Designcorenet/FRUGT/README.md

# FRUGT
An open source, affordable and accessible plant cultivation system.               
Note: This repository is still in its beginning.

WhatsApp Image 2023-02-15 at 18 12 42
