Designcorenet/FRUGT/DOCS/Flyer.pdf

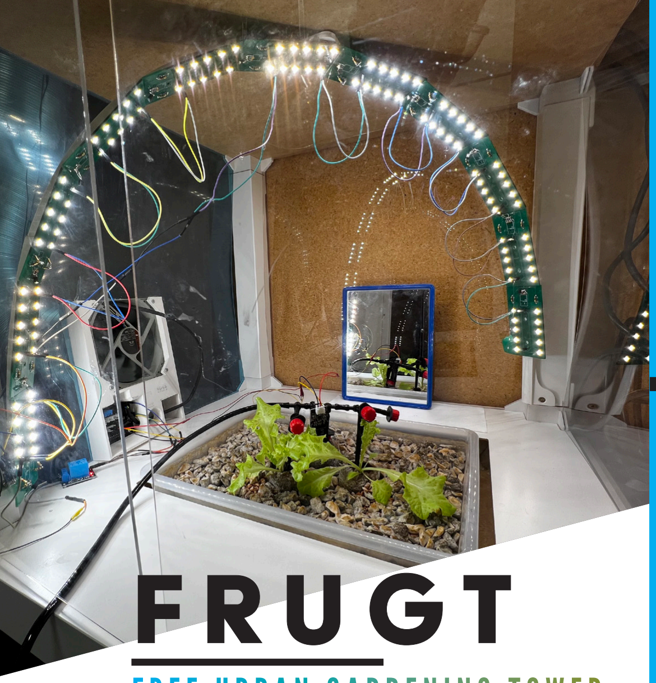
[picture p1: figure]
FRUGT

# KONTAKT

# EIN VORTEIL?

Der Pflanzenanbau innerhalb eines komplett von natürlichem Licht abgeschotteten FRUGT-System wurde untersucht. Die Pflanzen, welche innerhalb des Systems keimten, wurden sieben Tage nach der Keimung pickiert und separiert. Ein Teil blieb im System und ein anderer wurde auf einer Fensterbank im Februar in einer Wohnung platziert.

Die Pflanzen innerhalb des FRUGT-Systems hatten ein fast doppelt so hohes Feuchtgewicht und wiesen ein höheres Absorptionsspektrum auf. Dies ist ein Indikator für höheres Pflanzenwachstum.

Der eigene Anbau von Nutzpflanzen ist heutzutage substanziell, da dieser die Lieferketten verkürzt und somit mehr Autarkie ermöglicht und die Pflanzen nicht mit Pestiziden behandelt sind. Jedoch haben viele Menschen z.B. in Großstädten oft keine Möglichkeiten zum eigenen Pflanzenanbau und dieser gestaltet sich außerdem meist sehr zeitintensiv. Deswegen hat FRUGT das Ziel, der Entwicklung eines autarken für die breite Gesellschaft leicht zugänglichen Pflanzenanbau-Systems.

# Tim Weber

### Tel: +49 173 1045848 E-Mail: designcorenet@gmail.com https://github.com/Designcorenet

# FREE URBAN GARDENING TOWER

# E I N G R O S S E S D A N K E S C H Ö N F Ü R DIE UNTERSTÜTZUNG DURCH:

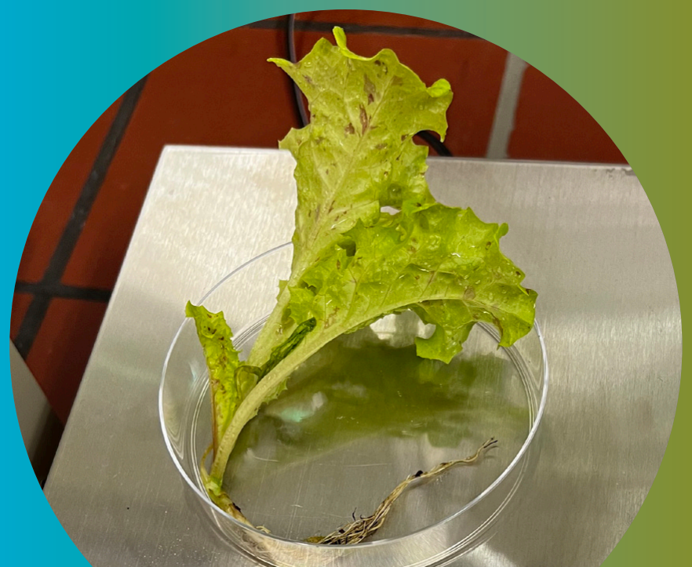
[picture p2: figure]

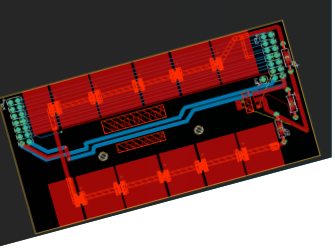
[picture p3: figure]

# DAS SYSTEM

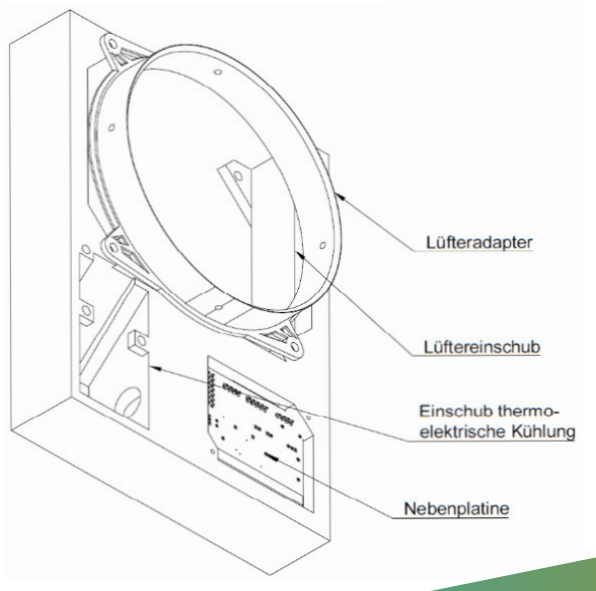
[picture p4: figure]
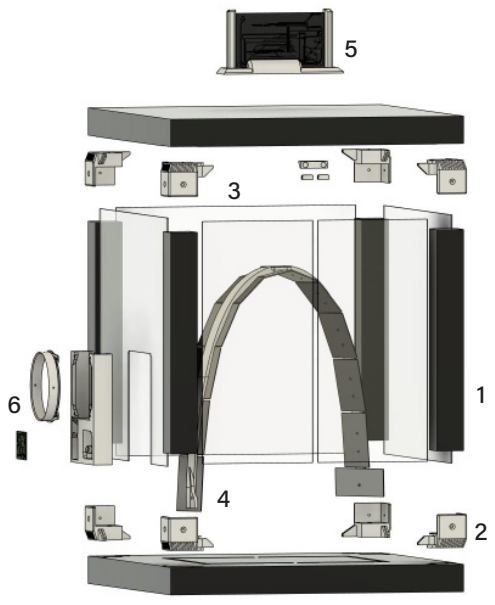
[picture p5: figure]

# DIE BELEUCHTUNG

Um einen möglichst effizienten Pflanzenanbau zu erreichen, der ebenfalls eine gewisse Preiswertigkeit und Autarkie aufweist, wurde ein System aus folgenden Komponenten entwickelt:

1. Ikea Lack Beistelltisch
2. 3D-gedruckte Zwischenteile
3. Plexiglas
4. LED-Beleuchtungsbogen
5. Hauptplatinen-Modul
6. Nebenplatinen-Modul
Um die Pflanzen auch im Winter oder in wenig beleuchteten Räumen effizient anbauen zu können, wurde ein LED-Beleuchtungsbogen entwickelt. Dieser besteht aus zwölf Platinen, welche einzeln ansteuerbar sind. Der Beleuchtungsbogen verfügt insgesamt über 120 LM301H LEDs mit einem für den Pflanzenanbau optimierten Spektrum.

# DIE ELEKTRONIK

Hauptplatinen-Modul:
- Arduino Mega 2560 als Herzstück
- ESP32-CAM für Datenlogging und Verbindung zum Internet
- Temperatur-/
Luftfeuchtigkeitssensor
- Hauptplatine ist mit bis zu drei Nebenplatinen verbindbar
--> bis zu dreistöckiges System möglich
Nebenplatinen-Modul:
- Bodenfeuchtigkeitssensor
- Beleuchtungsstärkensensor
- Temperatur-/
Luftfeuchtigkeitssensor
- Durchflusssensor
- PWM-Lüfter
- ws2182b Status-LED
