Designcorenet/FRUGT/STLs/enclosure_system/hinge_(4x).stl

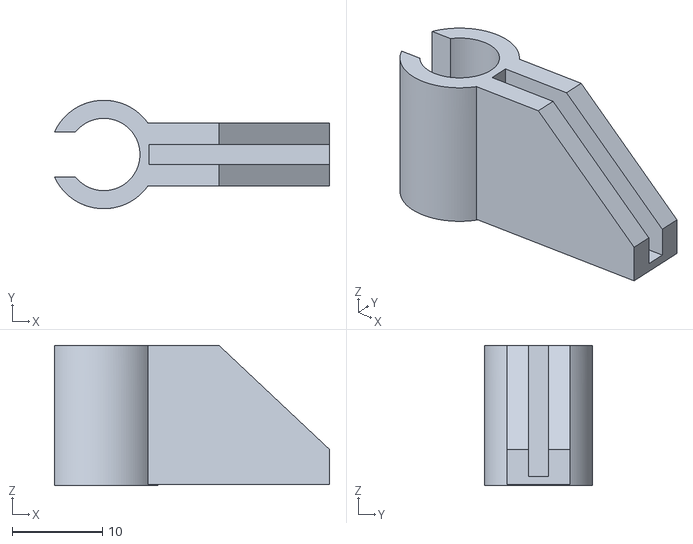
[picture p41: CAD file, 2022-09-10]
STLs/enclosure_system/hinge_(4x).stl
30.4 x 12.0 x 15.5
