Designcorenet/FRUGT/STLs/lightning/lightning_arc_a_(1x).stl

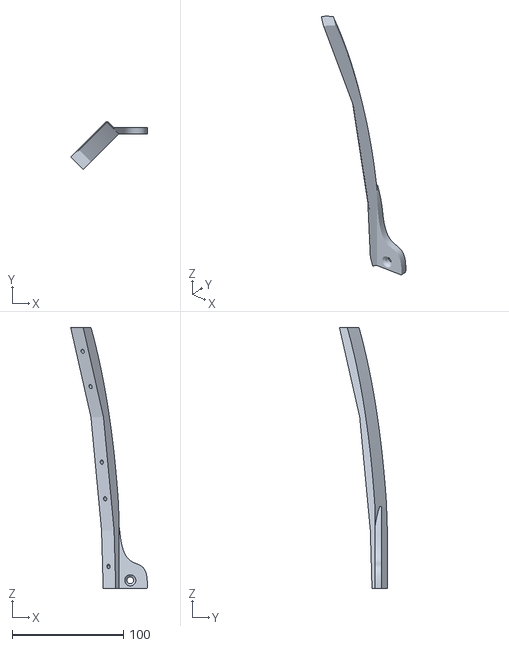
[picture p42: CAD file, 2022-09-10]
STLs/lightning/lightning_arc_a_(1x).stl
69.1 x 43.3 x 235.0
