Designcorenet/FRUGT/STLs/SEC_PCB/125_ventpipe_adapter_(1x).stl

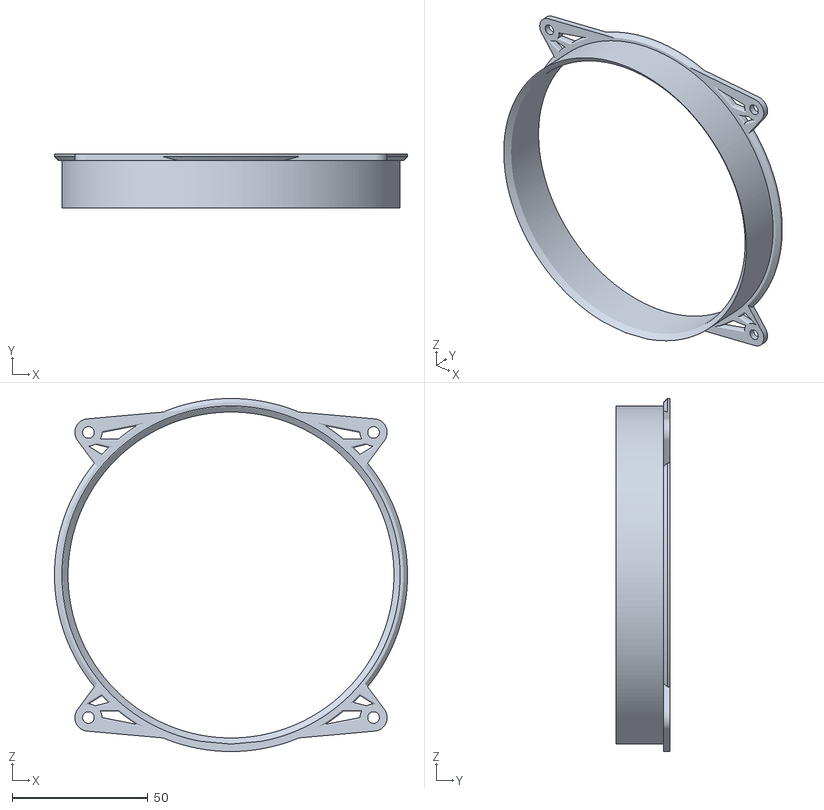
[picture p43: CAD file, 2022-09-10]
STLs/SEC_PCB/125_ventpipe_adapter_(1x).stl
130.0 x 20.0 x 130.0
