Designcorenet/FRUGT/STLs/enclosure_system/hinge_corner_piece_ b_(2x).stl

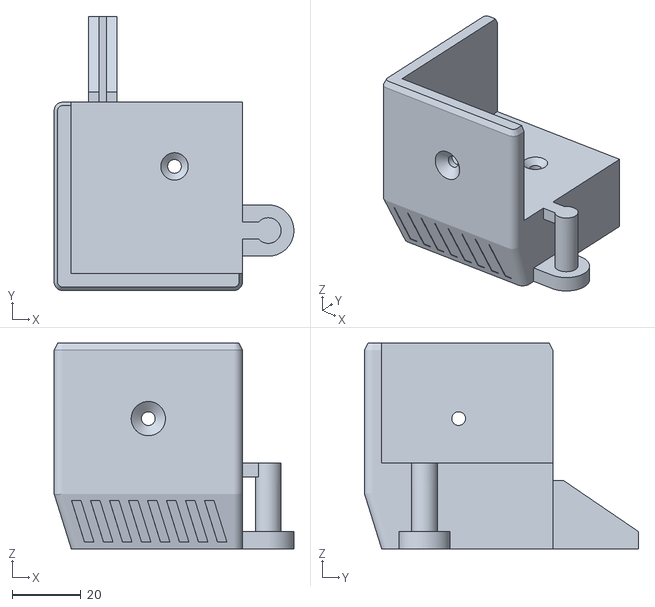
[picture p44: CAD file, 2022-09-10]
STLs/enclosure_system/hinge_corner_piece_ b_(2x).stl
70.0 x 80.0 x 60.0
