Designcorenet/FRUGT/STLs/lightning/lightning_arc_c_(1x).stl

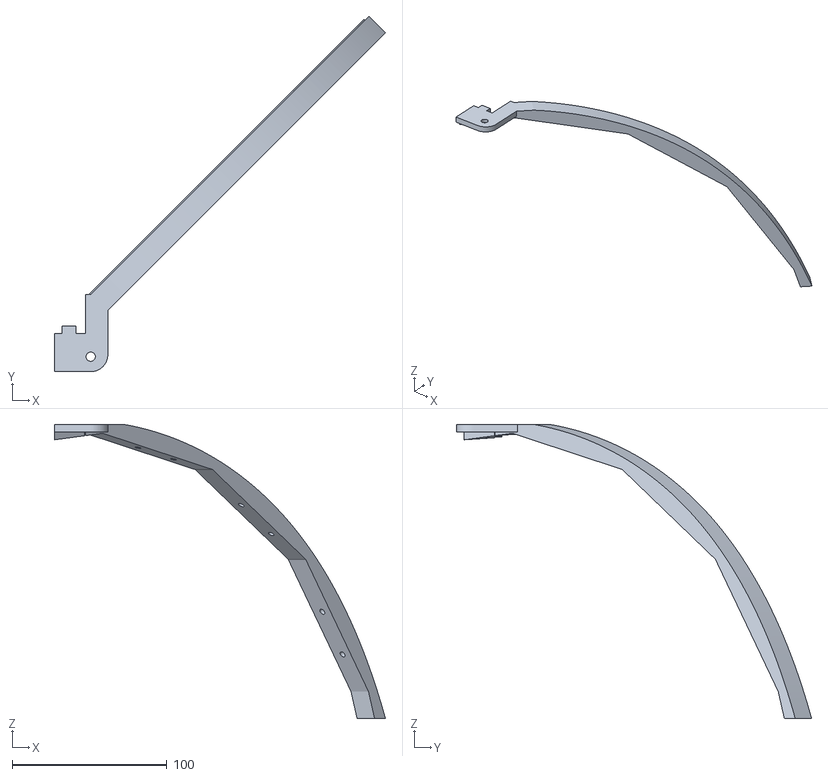
[picture p45: CAD file, 2022-09-10]
STLs/lightning/lightning_arc_c_(1x).stl
213.9 x 229.6 x 190.0
