Designcorenet/FRUGT/STLs/SEC_PCB/case_(1x).stl

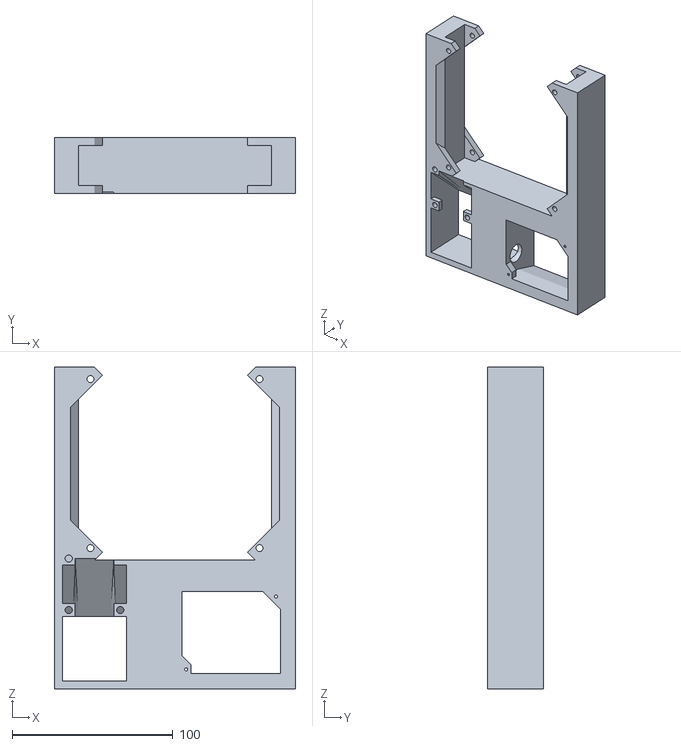
[picture p46: CAD file, 2022-09-10]
STLs/SEC_PCB/case_(1x).stl
150.0 x 35.0 x 200.0
