Designcorenet/FRUGT/STLs/enclosure_system/corner_piece_(4x).stl

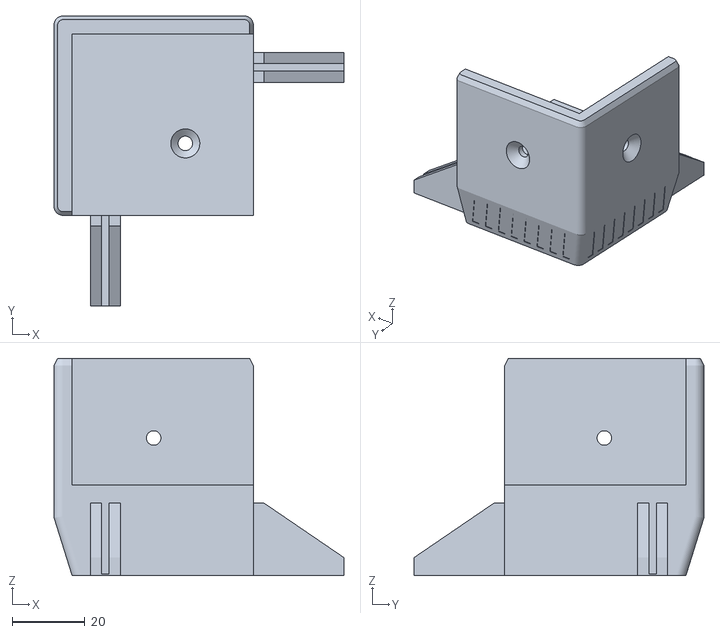
[picture p47: CAD file, 2022-09-10]
STLs/enclosure_system/corner_piece_(4x).stl
80.0 x 80.0 x 60.0
