Designcorenet/FRUGT/STLs/lightning/lightning_arc_d_(1x).stl

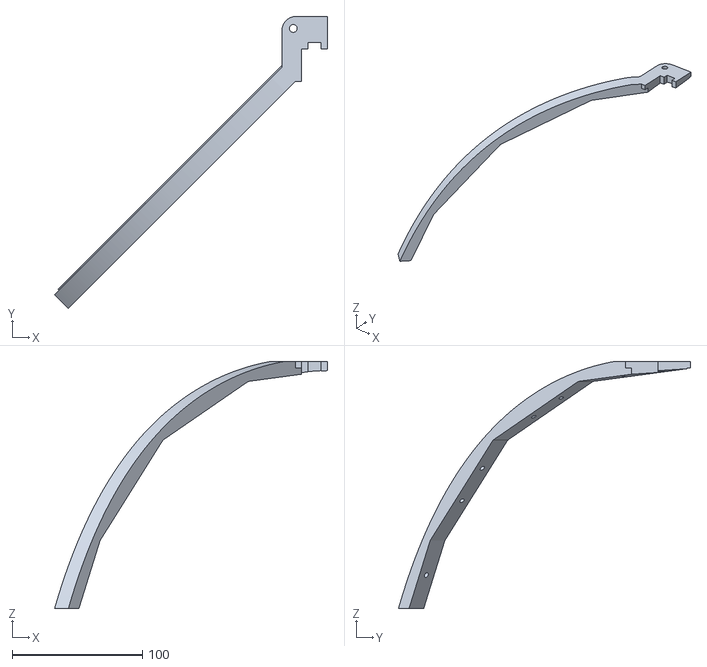
[picture p48: CAD file, 2022-09-10]
STLs/lightning/lightning_arc_d_(1x).stl
209.6 x 224.4 x 190.0
