Designcorenet/FRUGT/STLs/lightning/lightning_arc_b_(1x).stl

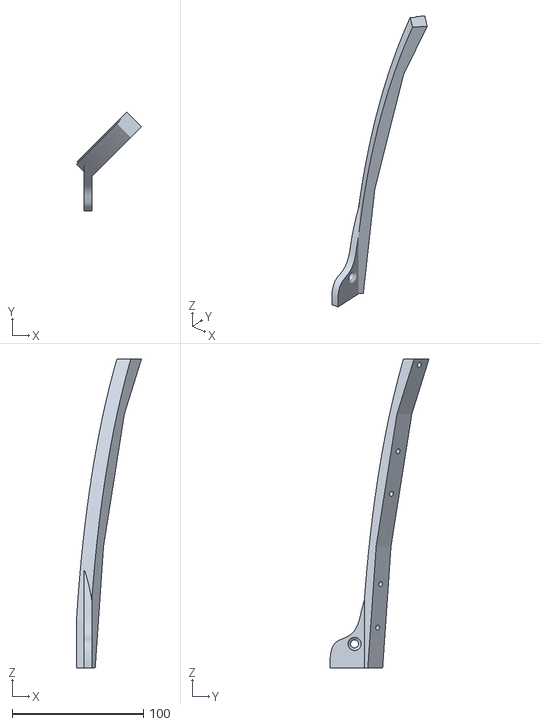
[picture p49: CAD file, 2022-09-10]
STLs/lightning/lightning_arc_b_(1x).stl
49.5 x 75.3 x 235.0
