Designcorenet/FRUGT/(list of files, cad)

Other CAD files:
STLs/enclosure_system/hinge_corner_piece_ a_(2x).stl
CAD/SEC_PCB_UNIT.f3z
