Designcorenet/FRUGT/DOCS/RESEARCH/[V0.1.3] Test 014/Chlorophyllmessung.xlsx

Sheet: Absorptionsspektrum (außerhalb
nm | A
400 | 1.350367
401 | 1.360017
402 | 1.370823
403 | 1.382584
404 | 1.393785
405 | 1.406865
406 | 1.418769
407 | 1.431487
408 | 1.442688
409 | 1.452875
410 | 1.460763
411 | 1.46645
412 | 1.468191
413 | 1.468026
414 | 1.464445
415 | 1.456767
416 | 1.448402
417 | 1.438849
418 | 1.42757
419 | 1.416126
420 | 1.404265
421 | 1.393262
422 | 1.383093
423 | 1.374043
424 | 1.365588
425 | 1.358942
426 | 1.354483
427 | 1.350386
428 | 1.348111
429 | 1.346051
430 | 1.344987
431 | 1.343271
432 | 1.34069
433 | 1.336376
434 | 1.330243
435 | 1.321752
436 | 1.310867
437 | 1.297927
438 | 1.283973
439 | 1.267827
440 | 1.252311
441 | 1.239303
442 | 1.227439
443 | 1.217059
444 | 1.209327
445 | 1.204161
446 | 1.200343
447 | 1.197965
448 | 1.196731
449 | 1.19505
450 | 1.194204
451 | 1.191871
452 | 1.18892
453 | 1.184911
454 | 1.17986
455 | 1.17289
456 | 1.165873
457 | 1.158028
458 | 1.148766
459 | 1.139548
460 | 1.130163
461 | 1.121749
462 | 1.113617
463 | 1.105798
464 | 1.098599
465 | 1.092374
466 | 1.086871
467 | 1.080719
468 | 1.075467
469 | 1.069602
470 | 1.061232
471 | 1.053774
472 | 1.044838
473 | 1.035081
474 | 1.024404
475 | 1.012545
476 | 1.000072
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
