Designcorenet/FRUGT/DOCS/RESEARCH/[V0.1.3] Test 014/Versuchsauswertung.xlsx

Pflanze | Feuchtgewicht (g) | Trockengewicht (g) | System
1 | 1.50 | 0.25 | FRUGT
2 | 2.80 | 0.6 | FRUGT | Trocknungsvorgang:
3 | 2.90 | 0.6 | FRUGT | 75°C für 20min
4 | 1.35 | 0.1 | Fensterbank
5 | 1.40 | 0.1 | Fensterbank | Durchschnitt
6 | 1.10 | 0.05 | Fensterbank | FRUGT Trocken | 0.4833333333
7 | 1.05 | 0.05 | Fensterbank | Fenster Trocken | 0.07
8 | 1.15 | 0.05 | Fensterbank | FRUGT Feucht | 2.40
 |  |  |  | Fenster Feucht | 1.21
