Designcorenet/FRUGT/PCBs/SEC_PCB/SEC_PCB_[V0.2].brd

## EAGLE design PCBs/SEC_PCB/SEC_PCB_[V0.2].brd (2022-09-10)

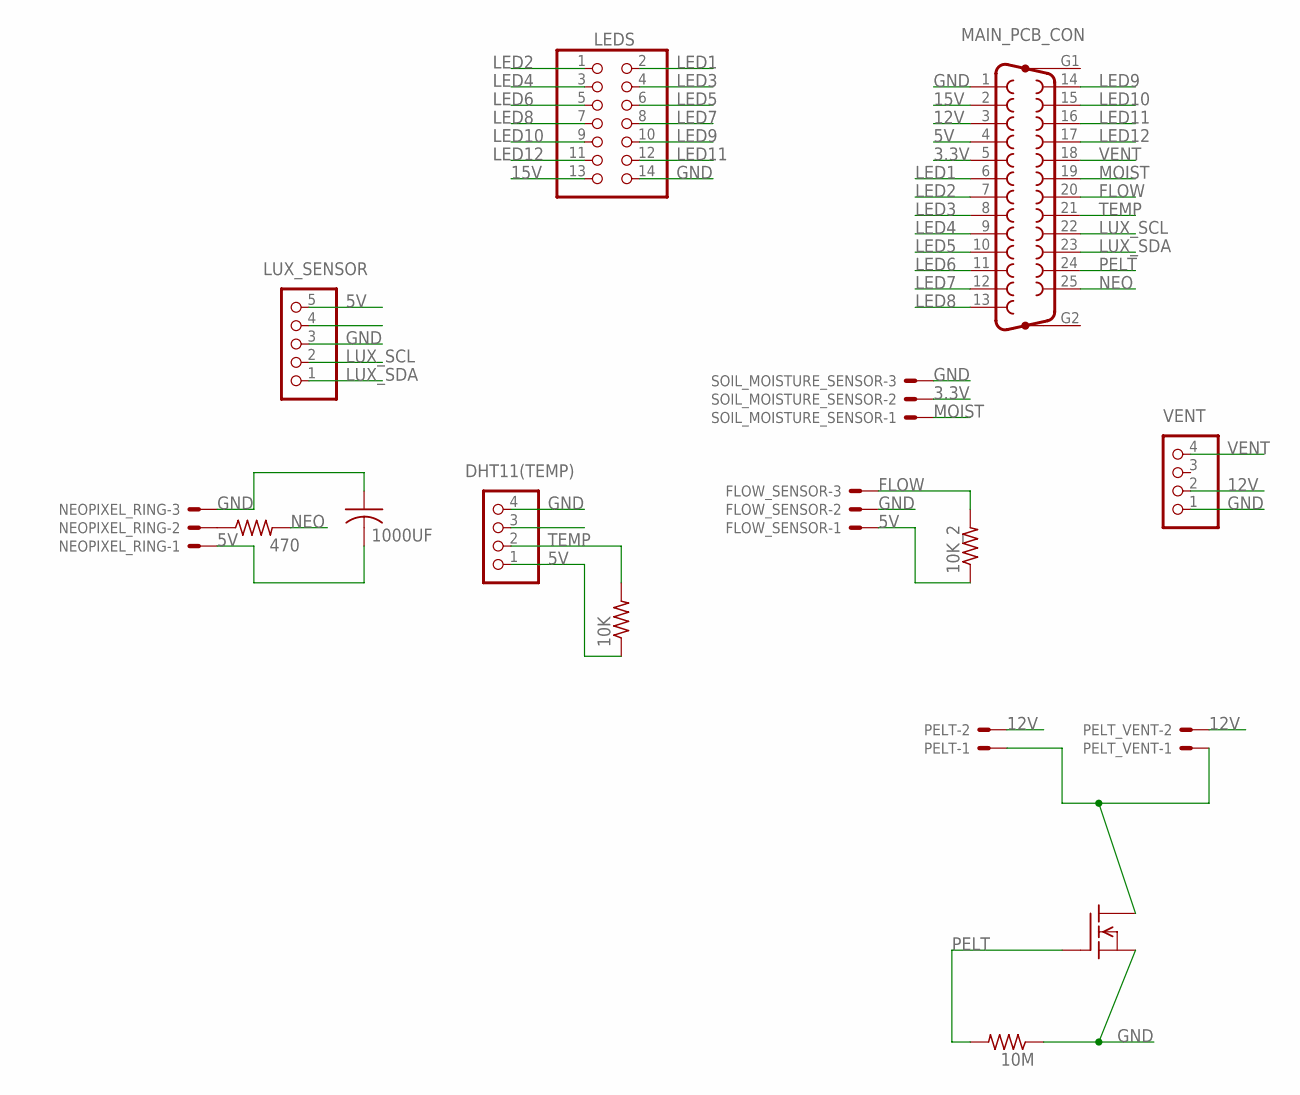
[picture p50: schematic SEC_PCB_[V0.2].sch]

Parts:
10K, 10K_2, 10M, 470: FLIPFLOP-RES; 0805-THM
1000UF: C-US050-035X075; C050-035X075
DHT11(TEMP): PINHD-1X4; 1X04
FLOW_SENSOR: JST-XH-03-PIN-LONG-PAD; JST-XH-03-PACKAGE-LONG-PAD
LEDS: PINHD-2X7; 2X07
LUX_SENSOR: PINHD-1X5; 1X05
MAIN_PCB_CON: F25VP
NEOPIXEL_RING: JST-XH-03-PIN-LONG-PAD; JST-XH-03-PACKAGE-LONG-PAD
PELT: JST-XH-02-PIN-LONG-PAD; JST-XH-02-PACKAGE-LONG-PAD
PELT_TRANSISTOR: FQN1N50C; TO92
PELT_VENT: JST-XH-02-PIN-LONG-PAD; JST-XH-02-PACKAGE-LONG-PAD
SOIL_MOISTURE_SENSOR: JST-XH-03-PIN-LONG-PAD; JST-XH-03-PACKAGE-LONG-PAD
VENT: PINHD-1X4; 1X04

Connections:
3.3V: MAIN_PCB_CON.5, SOIL_MOISTURE_SENSOR.2
5V: 10K.1, 10K_2.1, 1000UF.2, DHT11(TEMP).1, FLOW_SENSOR.1, LUX_SENSOR.5, MAIN_PCB_CON.4, NEOPIXEL_RING.1
12V: MAIN_PCB_CON.3, PELT.2, PELT_VENT.2, VENT.2
15V: LEDS.13, MAIN_PCB_CON.2
FLOW: 10K_2.2, FLOW_SENSOR.3, MAIN_PCB_CON.20
GND: 10M.1, 1000UF.1, DHT11(TEMP).4, FLOW_SENSOR.2, LEDS.14, LUX_SENSOR.3, MAIN_PCB_CON.1, NEOPIXEL_RING.3, PELT_TRANSISTOR.3 (S), SOIL_MOISTURE_SENSOR.3, VENT.1
LED1: LEDS.2, MAIN_PCB_CON.6
LED2: LEDS.1, MAIN_PCB_CON.7
LED3: LEDS.4, MAIN_PCB_CON.8
LED4: LEDS.3, MAIN_PCB_CON.9
LED5: LEDS.6, MAIN_PCB_CON.10
LED6: LEDS.5, MAIN_PCB_CON.11
LED7: LEDS.8, MAIN_PCB_CON.12
LED8: LEDS.7, MAIN_PCB_CON.13
LED9: LEDS.10, MAIN_PCB_CON.14
LED10: LEDS.9, MAIN_PCB_CON.15
LED11: LEDS.12, MAIN_PCB_CON.16
LED12: LEDS.11, MAIN_PCB_CON.17
LUX_SCL: LUX_SENSOR.2, MAIN_PCB_CON.22
LUX_SDA: LUX_SENSOR.1, MAIN_PCB_CON.23
MOIST: MAIN_PCB_CON.19, SOIL_MOISTURE_SENSOR.1
unnamed: 470.1, NEOPIXEL_RING.2
unnamed: PELT.1, PELT_TRANSISTOR.2 (D), PELT_VENT.1
NEO: 470.2, MAIN_PCB_CON.25
PELT: 10M.2, MAIN_PCB_CON.24, PELT_TRANSISTOR.1 (G)
TEMP: 10K.2, DHT11(TEMP).2, MAIN_PCB_CON.21
VENT: MAIN_PCB_CON.18, VENT.4

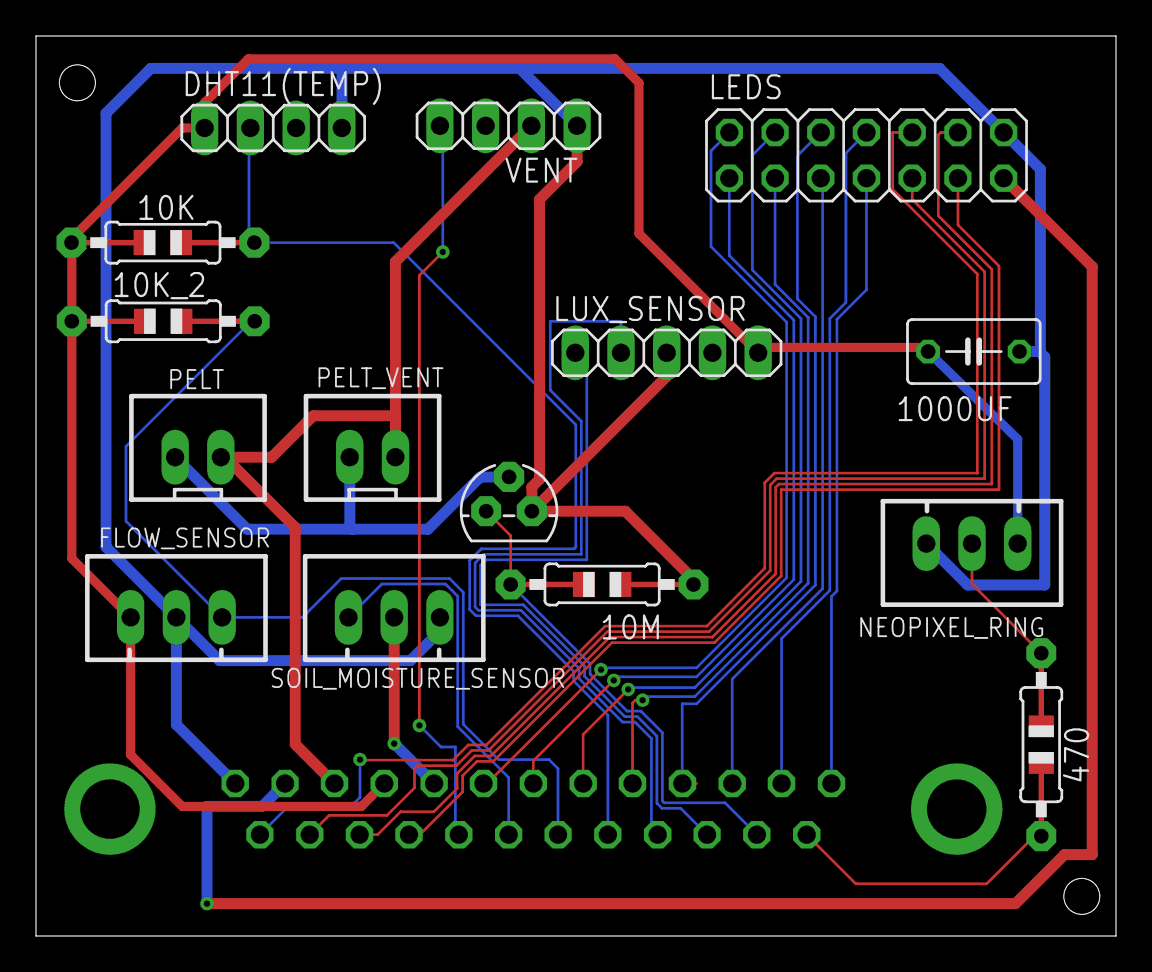
[picture p51: board SEC_PCB_[V0.2].brd from above]

Board: 2 copper layers, 60.0 x 50.0 mm, 16 parts (1 on the bottom side), 27 nets.
