Designcorenet/FRUGT/PCBs/MAIN_PCB/MAIN_PCB_[V0.2].brd

## EAGLE design PCBs/MAIN_PCB/MAIN_PCB_[V0.2].brd (2022-09-10)

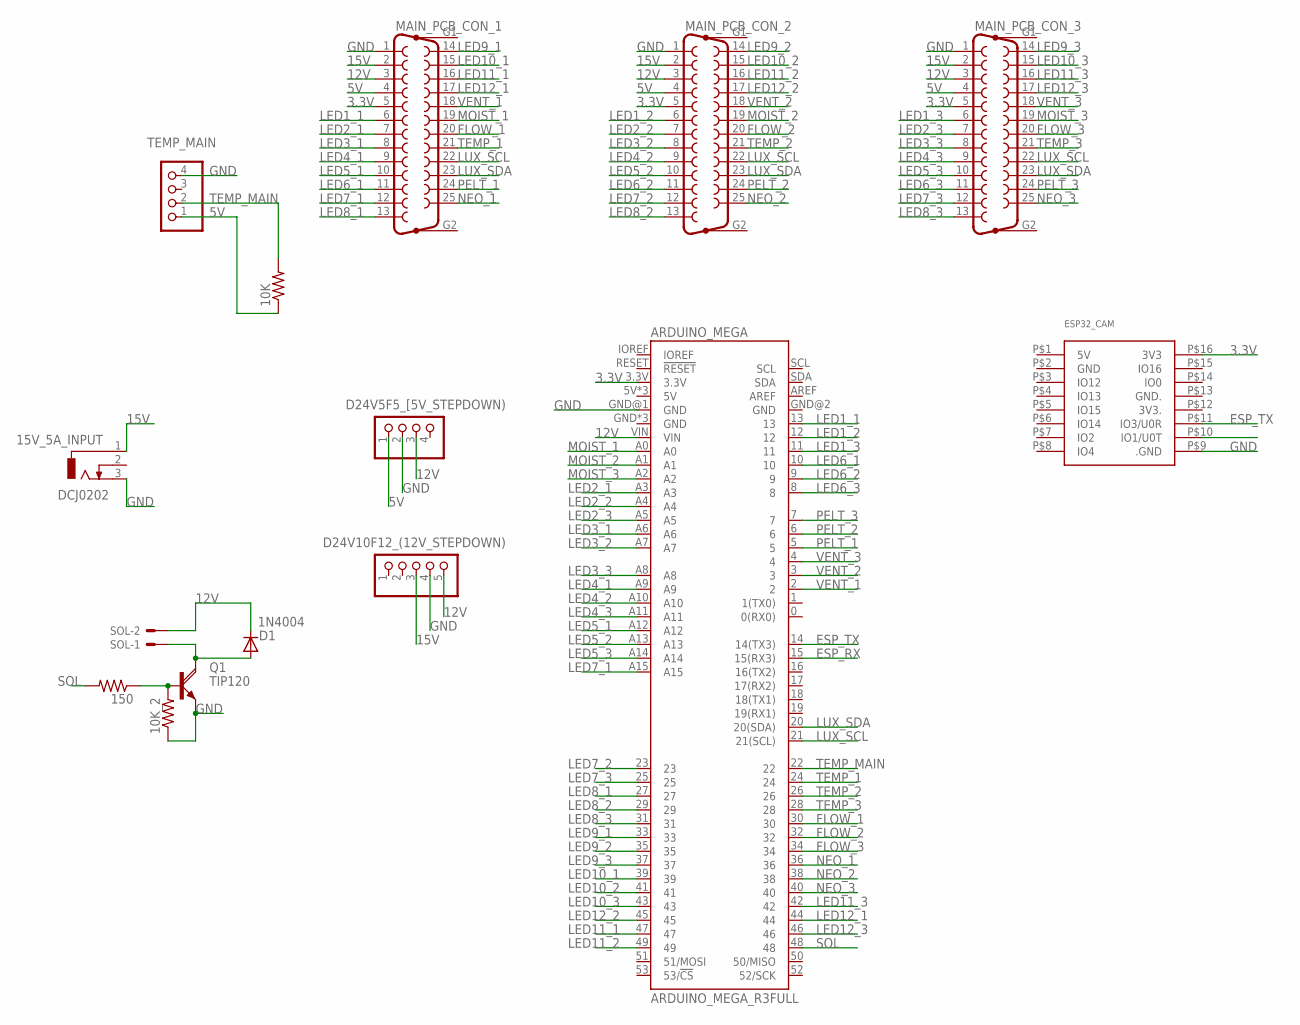
[picture p52: schematic MAIN_PCB_[V0.2].sch]

Parts:
10K, 10K_2, 150: FLIPFLOP-RES; 0805-THM
15V_5A_INPUT: DCJ0202
ARDUINO_MEGA: ARDUINO_MEGA_R3FULL; ARDUINO_MEGA_NO_SILK
D1: 1N4004; DO41-10
D24V5F5_[5V_STEPDOWN): PINHD-1X4; 1X04
D24V10F12_(12V_STEPDOWN): PINHD-1X5; 1X05
ESP32_CAM: ESP32-CAM
MAIN_PCB_CON_1, MAIN_PCB_CON_2, MAIN_PCB_CON_3: F25VP
Q1: TIP120; TO220AH
SOL: JST-XH-02-PIN-LONG-PAD; JST-XH-02-PACKAGE-LONG-PAD
TEMP_MAIN: PINHD-1X4; 1X04

Connections:
3.3V: ARDUINO_MEGA.3.3V, ESP32_CAM.P$16 (3V3), MAIN_PCB_CON_1.5, MAIN_PCB_CON_2.5, MAIN_PCB_CON_3.5
5V: 10K.1, D24V5F5_[5V_STEPDOWN).1, MAIN_PCB_CON_1.4, MAIN_PCB_CON_2.4, MAIN_PCB_CON_3.4, TEMP_MAIN.1
12V: ARDUINO_MEGA.VIN, D1.C, D24V5F5_[5V_STEPDOWN).3, D24V10F12_(12V_STEPDOWN).5, MAIN_PCB_CON_1.3, MAIN_PCB_CON_2.3, MAIN_PCB_CON_3.3, SOL.2
15V: 15V_5A_INPUT.1, D24V10F12_(12V_STEPDOWN).3, MAIN_PCB_CON_1.2, MAIN_PCB_CON_2.2, MAIN_PCB_CON_3.2
ESP_RX: ARDUINO_MEGA.15 (15(RX3)), ESP32_CAM.P$10 (IO1/U0T)
ESP_TX: ARDUINO_MEGA.14 (14(TX3)), ESP32_CAM.P$11 (IO3/U0R)
FLOW_1: ARDUINO_MEGA.30, MAIN_PCB_CON_1.20
FLOW_2: ARDUINO_MEGA.32, MAIN_PCB_CON_2.20
FLOW_3: ARDUINO_MEGA.34, MAIN_PCB_CON_3.20
GND: 10K_2.1, 15V_5A_INPUT.3, ARDUINO_MEGA.GND@1 (GND), D24V5F5_[5V_STEPDOWN).2, D24V10F12_(12V_STEPDOWN).4, ESP32_CAM.P$9 (.GND), MAIN_PCB_CON_1.1, MAIN_PCB_CON_2.1, MAIN_PCB_CON_3.1, Q1.E, TEMP_MAIN.4
LED1_1: ARDUINO_MEGA.13, MAIN_PCB_CON_1.6
LED1_2: ARDUINO_MEGA.12, MAIN_PCB_CON_2.6
LED1_3: ARDUINO_MEGA.11, MAIN_PCB_CON_3.6
LED2_1: ARDUINO_MEGA.A3, MAIN_PCB_CON_1.7
LED2_2: ARDUINO_MEGA.A4, MAIN_PCB_CON_2.7
LED2_3: ARDUINO_MEGA.A5, MAIN_PCB_CON_3.7
LED3_1: ARDUINO_MEGA.A6, MAIN_PCB_CON_1.8
LED3_2: ARDUINO_MEGA.A7, MAIN_PCB_CON_2.8
LED3_3: ARDUINO_MEGA.A8, MAIN_PCB_CON_3.8
LED4_1: ARDUINO_MEGA.A9, MAIN_PCB_CON_1.9
LED4_2: ARDUINO_MEGA.A10, MAIN_PCB_CON_2.9
LED4_3: ARDUINO_MEGA.A11, MAIN_PCB_CON_3.9
LED5_1: ARDUINO_MEGA.A12, MAIN_PCB_CON_1.10
LED5_2: ARDUINO_MEGA.A13, MAIN_PCB_CON_2.10
LED5_3: ARDUINO_MEGA.A14, MAIN_PCB_CON_3.10
LED6_1: ARDUINO_MEGA.10, MAIN_PCB_CON_1.11
LED6_2: ARDUINO_MEGA.9, MAIN_PCB_CON_2.11
LED6_3: ARDUINO_MEGA.8, MAIN_PCB_CON_3.11
LED7_1: ARDUINO_MEGA.A15, MAIN_PCB_CON_1.12
LED7_2: ARDUINO_MEGA.23, MAIN_PCB_CON_2.12
LED7_3: ARDUINO_MEGA.25, MAIN_PCB_CON_3.12
LED8_1: ARDUINO_MEGA.27, MAIN_PCB_CON_1.13
LED8_2: ARDUINO_MEGA.29, MAIN_PCB_CON_2.13
LED8_3: ARDUINO_MEGA.31, MAIN_PCB_CON_3.13
LED9_1: ARDUINO_MEGA.33, MAIN_PCB_CON_1.14
LED9_2: ARDUINO_MEGA.35, MAIN_PCB_CON_2.14
LED9_3: ARDUINO_MEGA.37, MAIN_PCB_CON_3.14
LED10_1: ARDUINO_MEGA.39, MAIN_PCB_CON_1.15
LED10_2: ARDUINO_MEGA.41, MAIN_PCB_CON_2.15
LED10_3: ARDUINO_MEGA.43, MAIN_PCB_CON_3.15
LED11_1: ARDUINO_MEGA.47, MAIN_PCB_CON_1.16
LED11_2: ARDUINO_MEGA.49, MAIN_PCB_CON_2.16
LED11_3: ARDUINO_MEGA.42, MAIN_PCB_CON_3.16
LED12_1: ARDUINO_MEGA.44, MAIN_PCB_CON_1.17
LED12_2: ARDUINO_MEGA.45, MAIN_PCB_CON_2.17
LED12_3: ARDUINO_MEGA.46, MAIN_PCB_CON_3.17
LUX_SCL: ARDUINO_MEGA.21 (21(SCL)), MAIN_PCB_CON_1.22, MAIN_PCB_CON_2.22, MAIN_PCB_CON_3.22
LUX_SDA: ARDUINO_MEGA.20 (20(SDA)), MAIN_PCB_CON_1.23, MAIN_PCB_CON_2.23, MAIN_PCB_CON_3.23
MOIST_1: ARDUINO_MEGA.A0, MAIN_PCB_CON_1.19
MOIST_2: ARDUINO_MEGA.A1, MAIN_PCB_CON_2.19
MOIST_3: ARDUINO_MEGA.A2, MAIN_PCB_CON_3.19
unnamed: D1.A, Q1.C, SOL.1
unnamed: 10K_2.2, 150.1, Q1.B
NEO_1: ARDUINO_MEGA.36, MAIN_PCB_CON_1.25
NEO_2: ARDUINO_MEGA.38, MAIN_PCB_CON_2.25
NEO_3: ARDUINO_MEGA.40, MAIN_PCB_CON_3.25
PELT_1: ARDUINO_MEGA.5, MAIN_PCB_CON_1.24
PELT_2: ARDUINO_MEGA.6, MAIN_PCB_CON_2.24
PELT_3: ARDUINO_MEGA.7, MAIN_PCB_CON_3.24
SOL: 150.2, ARDUINO_MEGA.48
TEMP_1: ARDUINO_MEGA.24, MAIN_PCB_CON_1.21
TEMP_2: ARDUINO_MEGA.26, MAIN_PCB_CON_2.21
TEMP_3: ARDUINO_MEGA.28, MAIN_PCB_CON_3.21
TEMP_MAIN: 10K.2, ARDUINO_MEGA.22, TEMP_MAIN.2
VENT_1: ARDUINO_MEGA.2, MAIN_PCB_CON_1.18
VENT_2: ARDUINO_MEGA.3, MAIN_PCB_CON_2.18
VENT_3: ARDUINO_MEGA.4, MAIN_PCB_CON_3.18

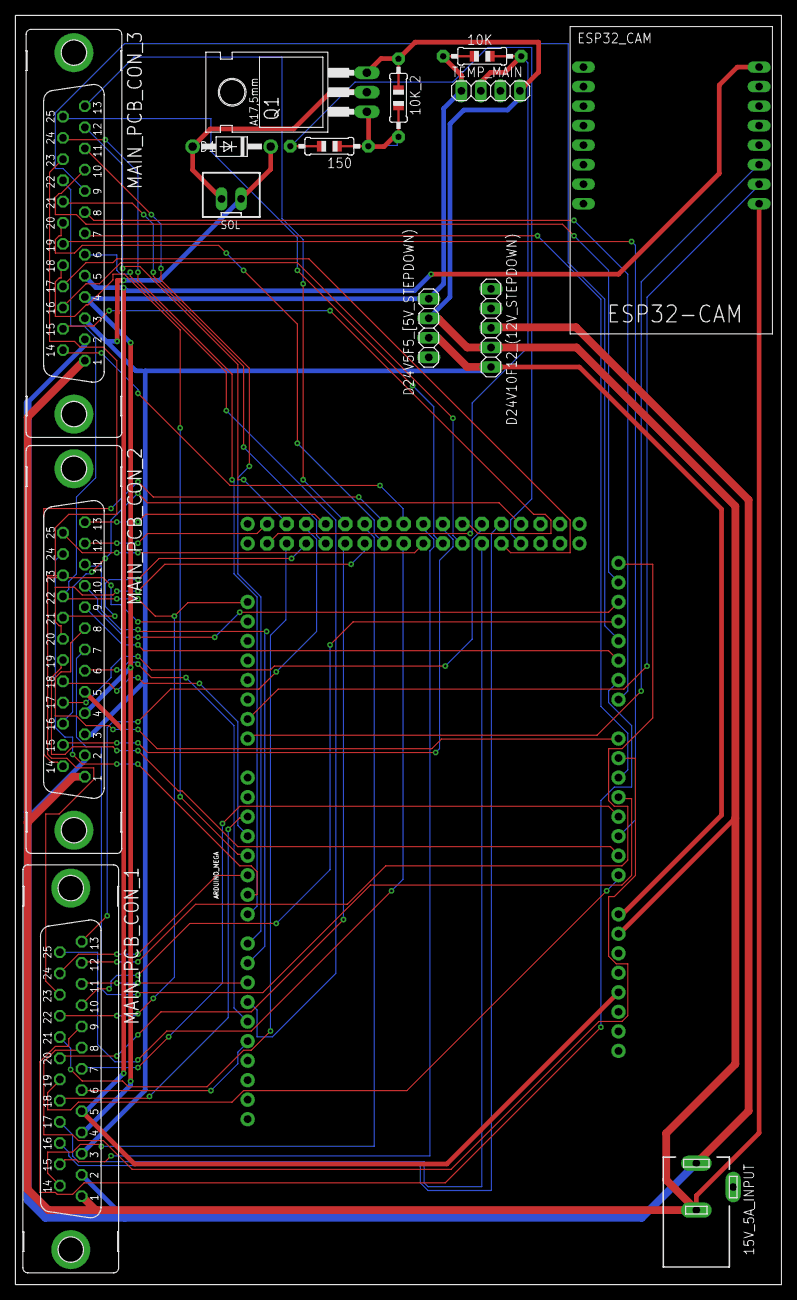
[picture p53: board MAIN_PCB_[V0.2].brd from above]

Board: 2 copper layers, 99.7 x 165.2 mm, 15 parts (0 on the bottom side), 67 nets.
