Designcorenet/FRUGT/PCBs/LED_PCB/LED.brd

## EAGLE design PCBs/LED_PCB/LED.brd (2022-09-10)

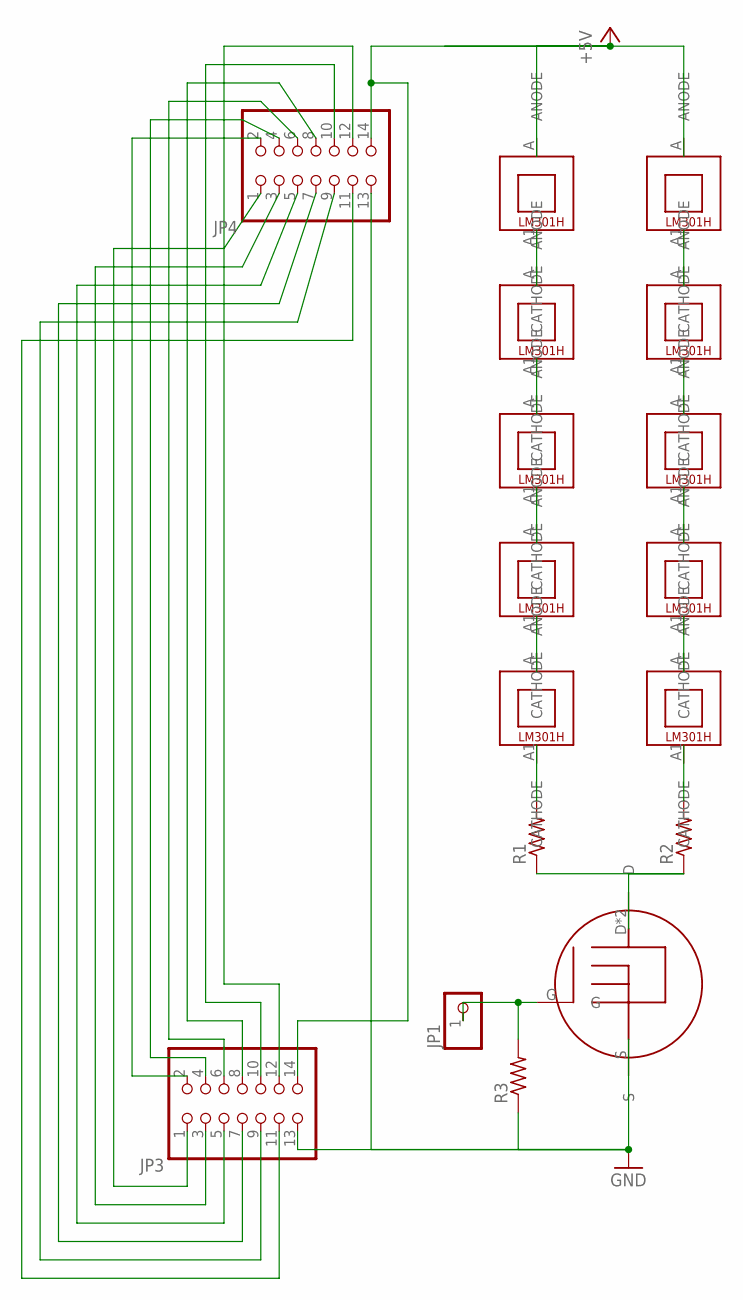
[picture p54: schematic LED.sch]

Parts:
JP1: PINHD-1X1; 1X01
JP3, JP4: PINHD-2X7; 2X07
R1, R2, R3: FLIPFLOP-RES; 0805-THM
U$1, U$2, U$3, U$4, U$5, U$6, U$7, U$8, U$9, U$10: LM301H; SPMWHD32AMH5XAT5SL
U$11: SOT223; S

Connections:
GND: JP3.13, JP4.13, R3.1, U$11.S
unnamed: JP3.12, JP4.12
unnamed: JP3.1, JP4.1
unnamed: R2.2, U$10.A1 (CATHODE)
unnamed: U$9.A1 (CATHODE), U$10.A (ANODE)
unnamed: U$8.A1 (CATHODE), U$9.A (ANODE)
unnamed: U$7.A1 (CATHODE), U$8.A (ANODE)
unnamed: U$6.A1 (CATHODE), U$7.A (ANODE)
unnamed: R1.2, U$5.A1 (CATHODE)
unnamed: U$4.A1 (CATHODE), U$5.A (ANODE)
unnamed: U$3.A1 (CATHODE), U$4.A (ANODE)
unnamed: U$2.A1 (CATHODE), U$3.A (ANODE)
unnamed: U$1.A1 (CATHODE), U$2.A (ANODE)
unnamed: JP3.2, JP4.2
unnamed: JP3.3, JP4.3
unnamed: JP3.4, JP4.4
unnamed: JP3.5, JP4.5
unnamed: JP3.6, JP4.6
unnamed: JP3.7, JP4.7
unnamed: JP3.8, JP4.8
unnamed: JP3.9, JP4.9
unnamed: JP3.10, JP4.10
unnamed: JP3.11, JP4.11
unnamed: JP1.1, R3.2, U$11.G
VCC: JP3.14, JP4.14, U$1.A (ANODE), U$6.A (ANODE)
_GND: R1.1, R2.1, U$11.D, U$11.DKLEIN (D)

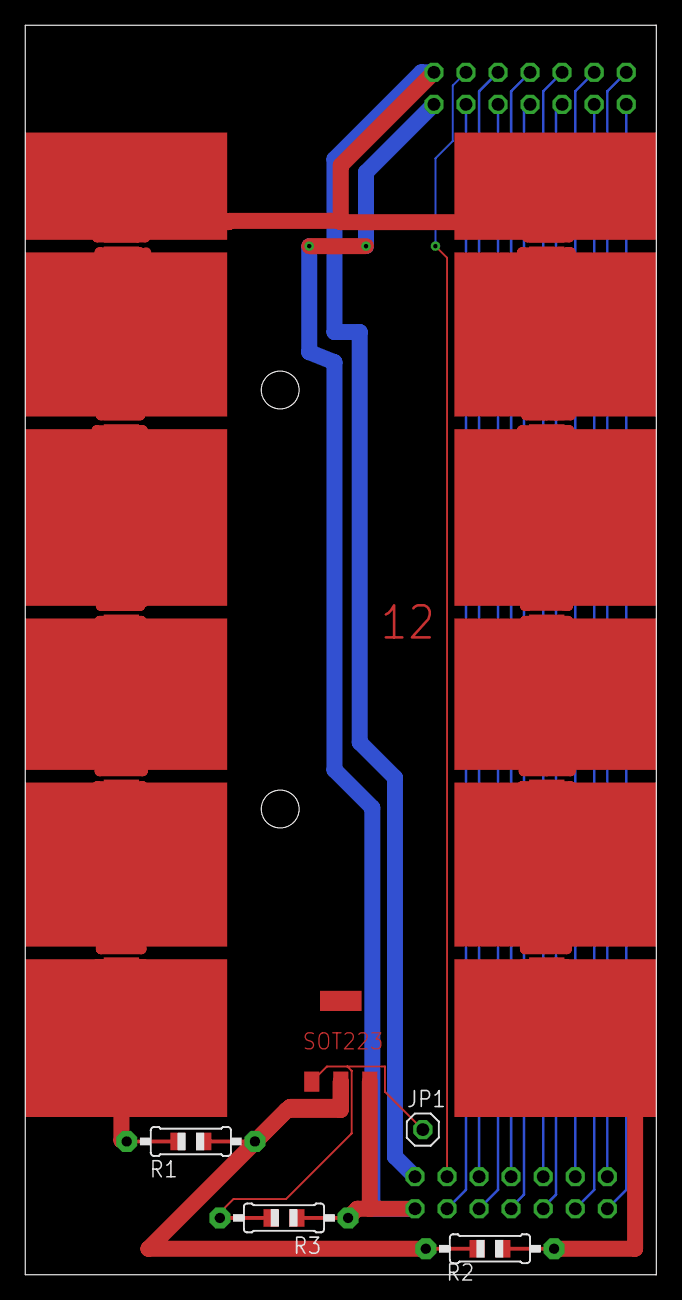
[picture p55: board LED.brd from above]

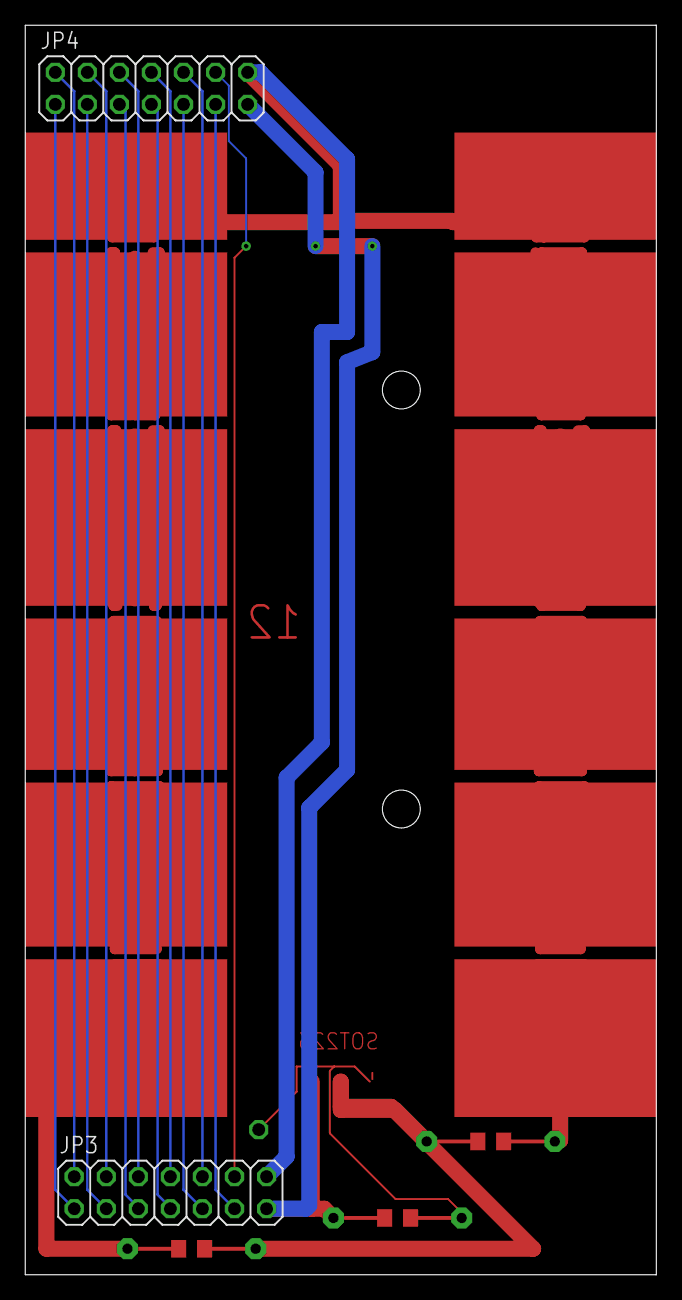
[picture p56: board LED.brd from below]

Board: 2 copper layers, 50.0 x 99.0 mm, 17 parts (2 on the bottom side), 26 nets.
