Designcorenet/FRUGT/(commit log)

2022-10-21 main code Arduino MEGA
2022-10-21 Platformio fix i guess.....
    [main.cpp]
